jtmaston/CIMPLC-Hardware/docs/docfiles/topics/CAN.md

# CAN

WIP Section

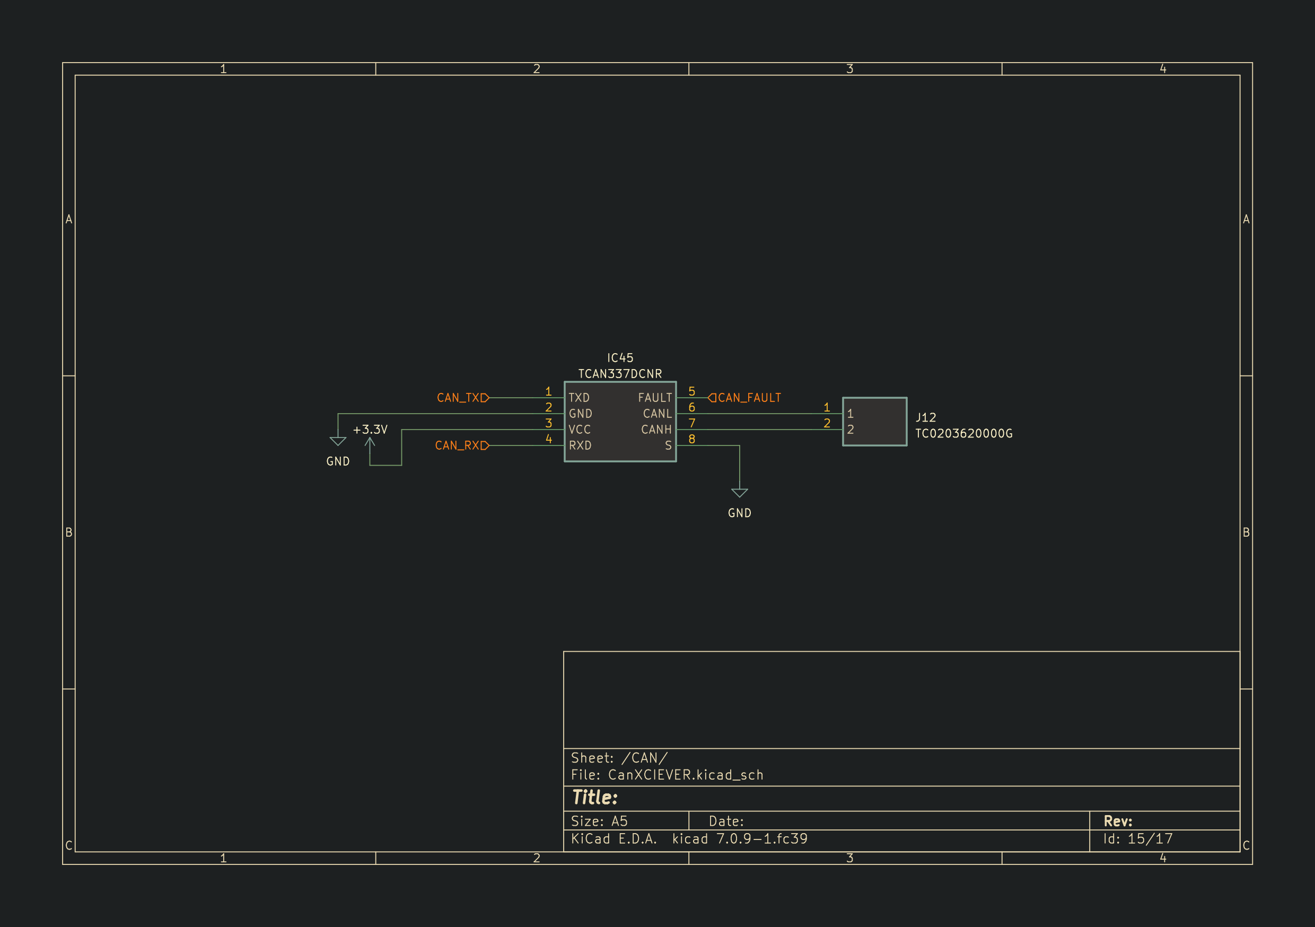
[picture p2: docs/CIMPLC-Hardware/image_4.png]
