jtmaston/CIMPLC-Hardware/docs/docfiles/topics/EEPROM.md

# EEPROM

WIP Section

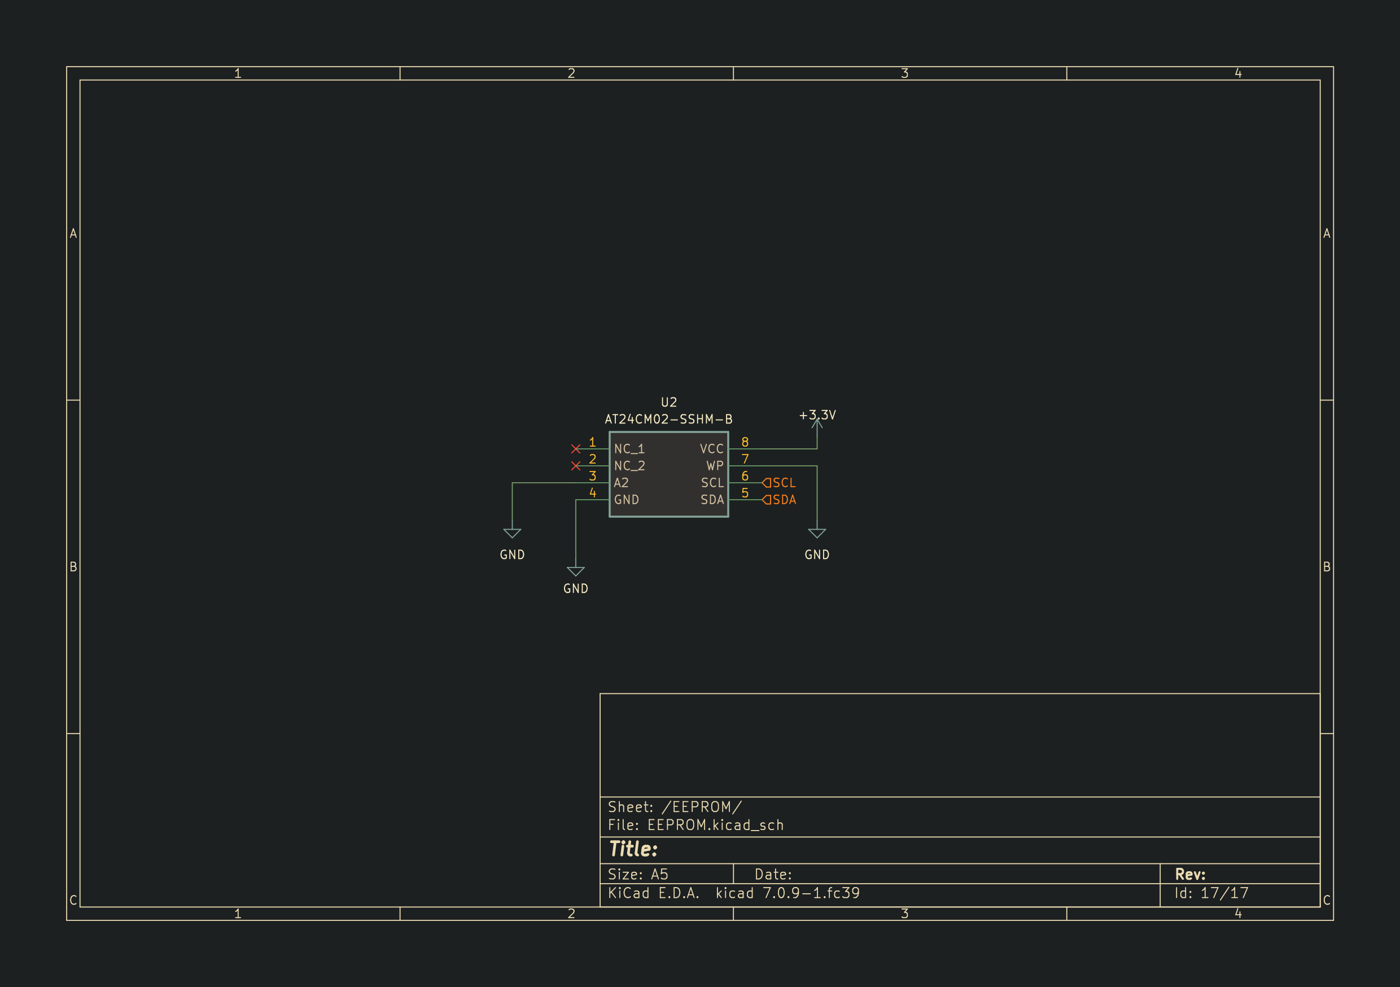
[picture p4: docs/CIMPLC-Hardware/image_6.png]
