jtmaston/CIMPLC-Hardware/docs/docfiles/topics/I-Block.md

# I Block

WIP Section

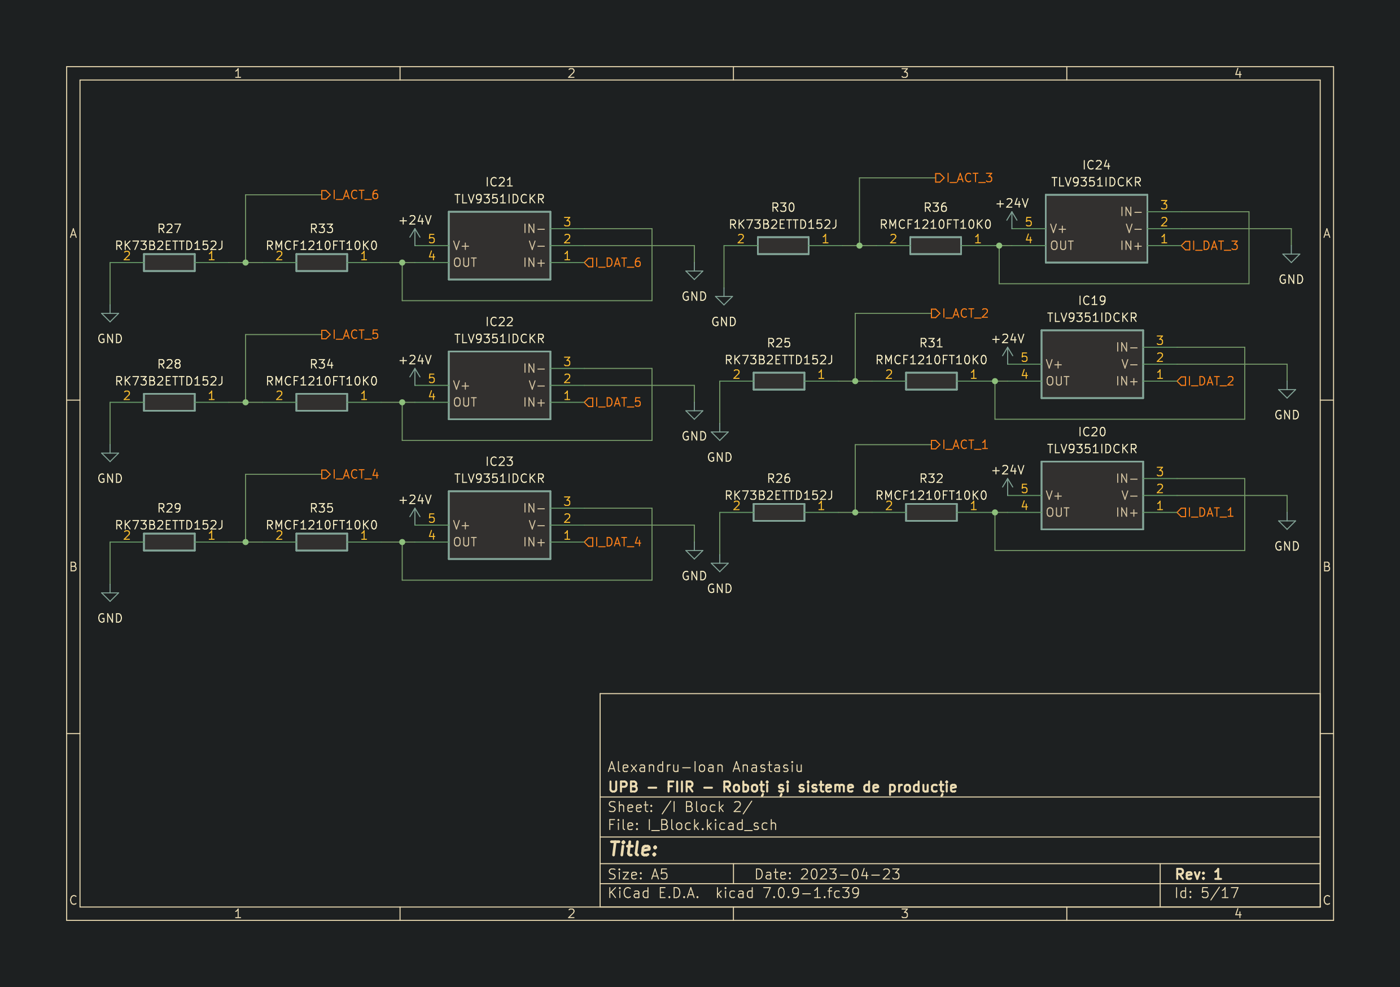
[picture p5: docs/CIMPLC-Hardware/image_7.png]
