jtmaston/CIMPLC-Hardware/docs/docfiles/topics/Output-Block.md

# Output Block

WIP Section

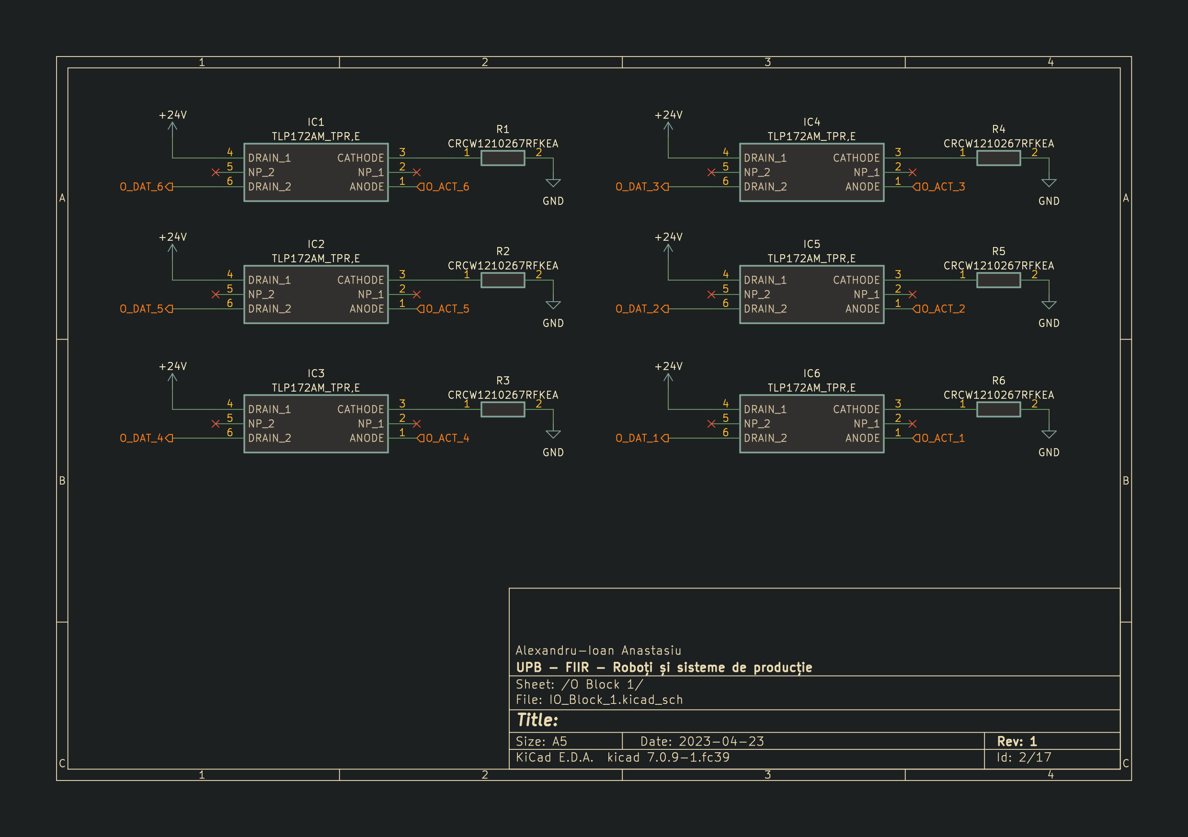
[picture p6: docs/CIMPLC-Hardware/image_1.png]
