jtmaston/CIMPLC-Hardware/docs/docfiles/topics/Remote-I-O.md

# Remote I/O

WIP Section

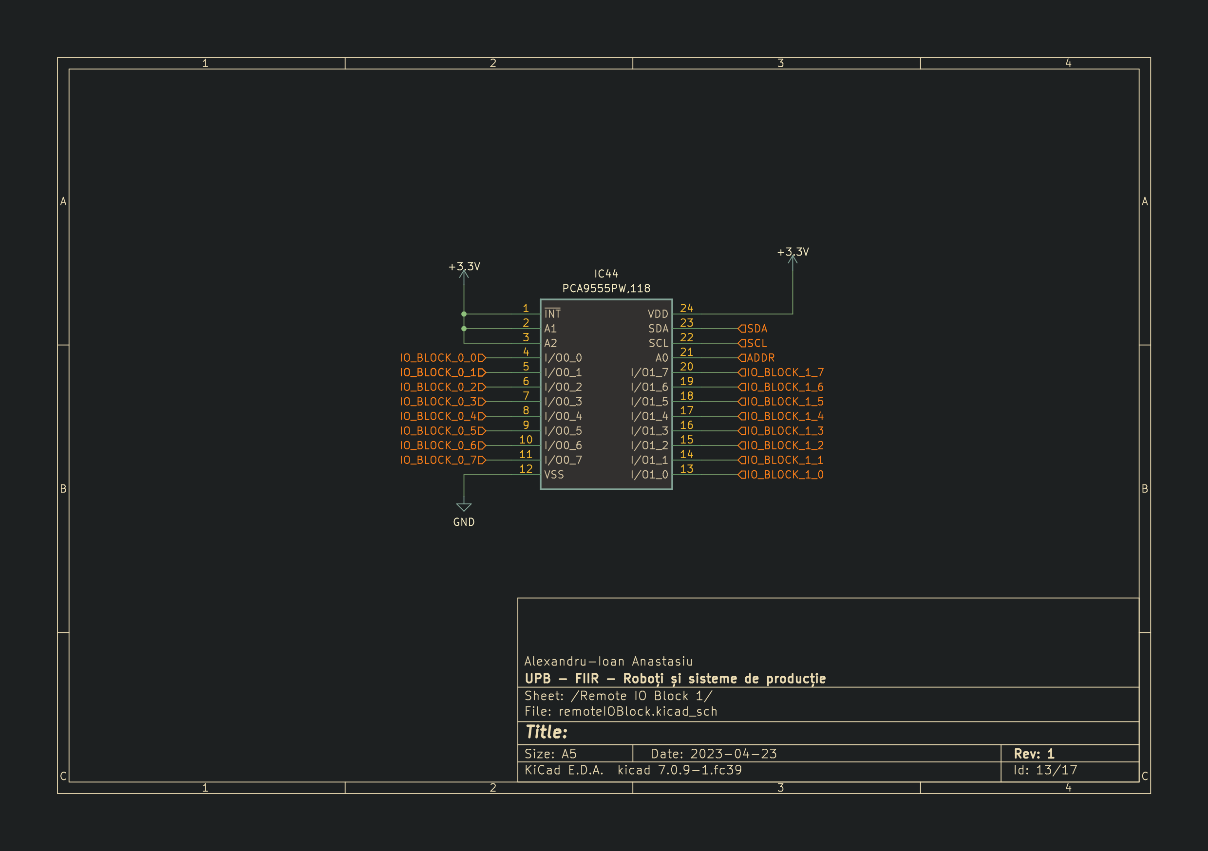
[picture p7: docs/CIMPLC-Hardware/image_2.png]
