jtmaston/CIMPLC-Hardware/docs/docfiles/topics/RS232.md

# RS232

WIP Section

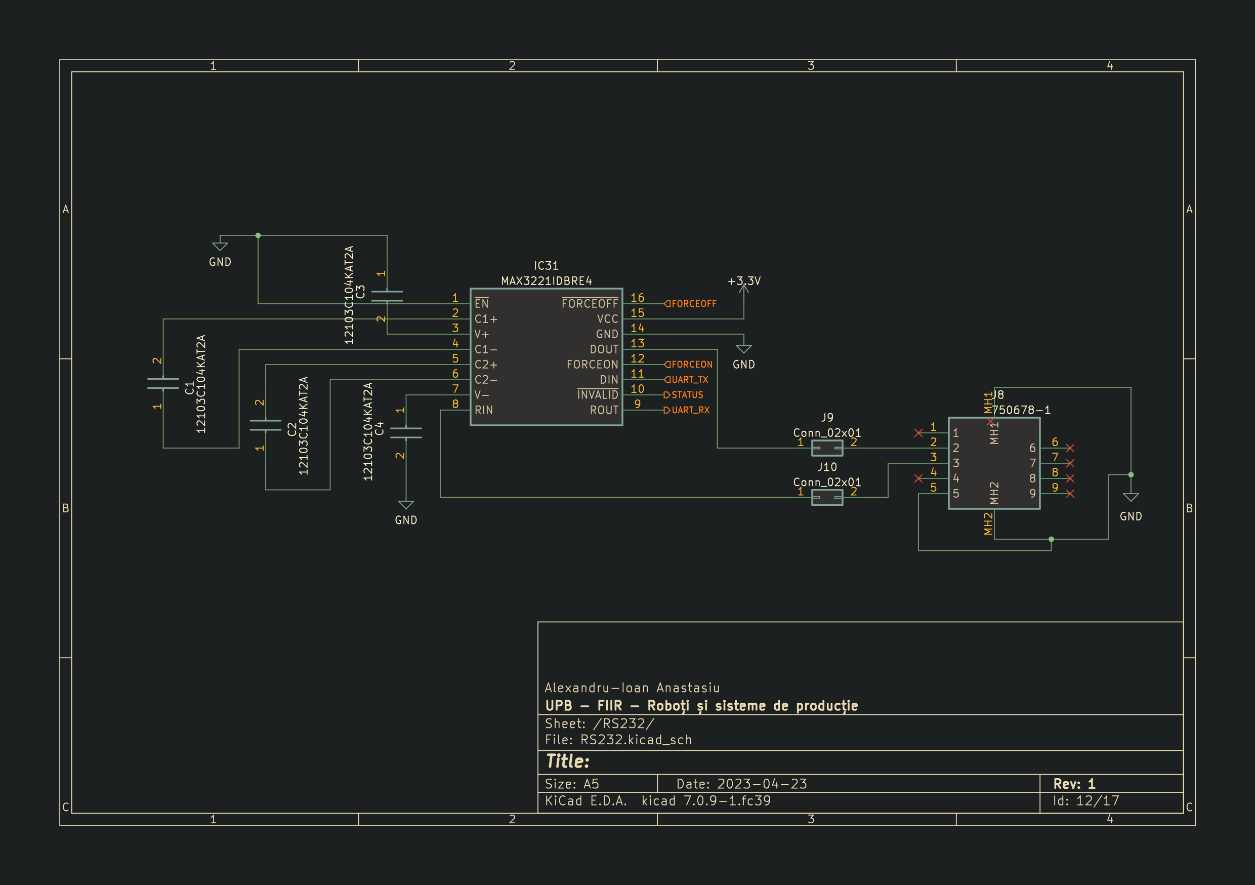
[picture p8: docs/CIMPLC-Hardware/image_3.png]
