jtmaston/CIMPLC-Hardware/docs/docfiles/topics/RS485.md

# RS485

WIP Section

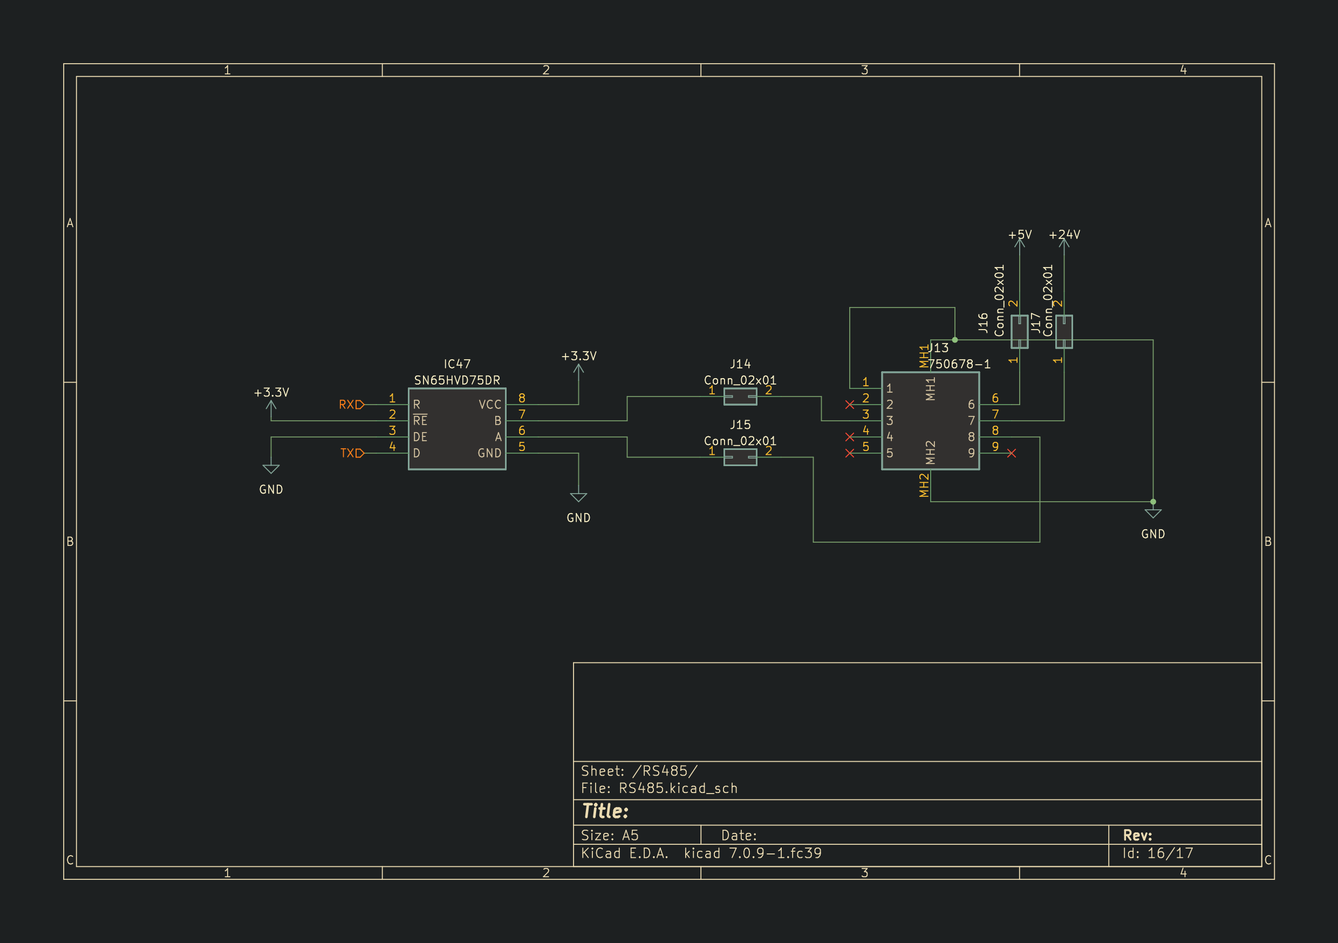
[picture p9: docs/CIMPLC-Hardware/image_5.png]
