jtmaston/CIMPLC-Hardware/docs/docfiles/images/image.png

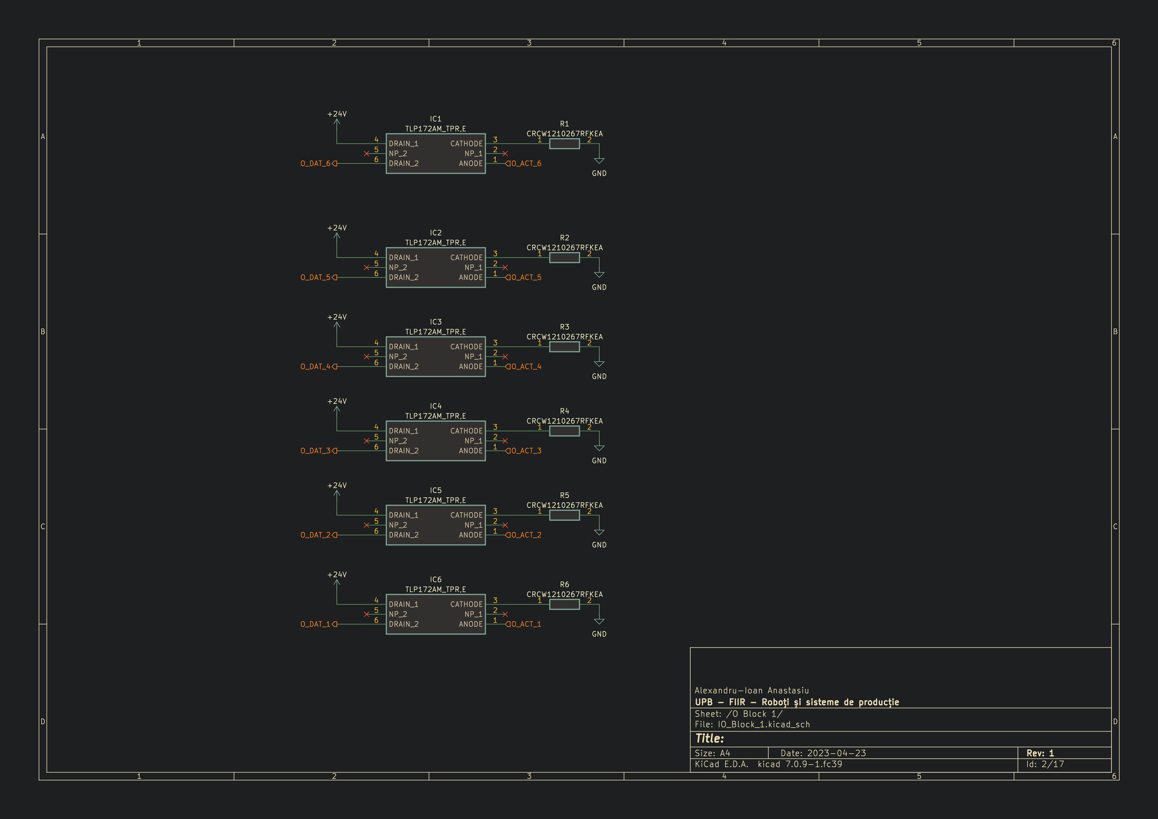
docs/docfiles/images/image.png
