jtmaston/CIMPLC-Hardware/v2/PLC-CIM.kicad_pcb

## KiCad design v2/PLC-CIM.kicad_pcb (2024-04-08)

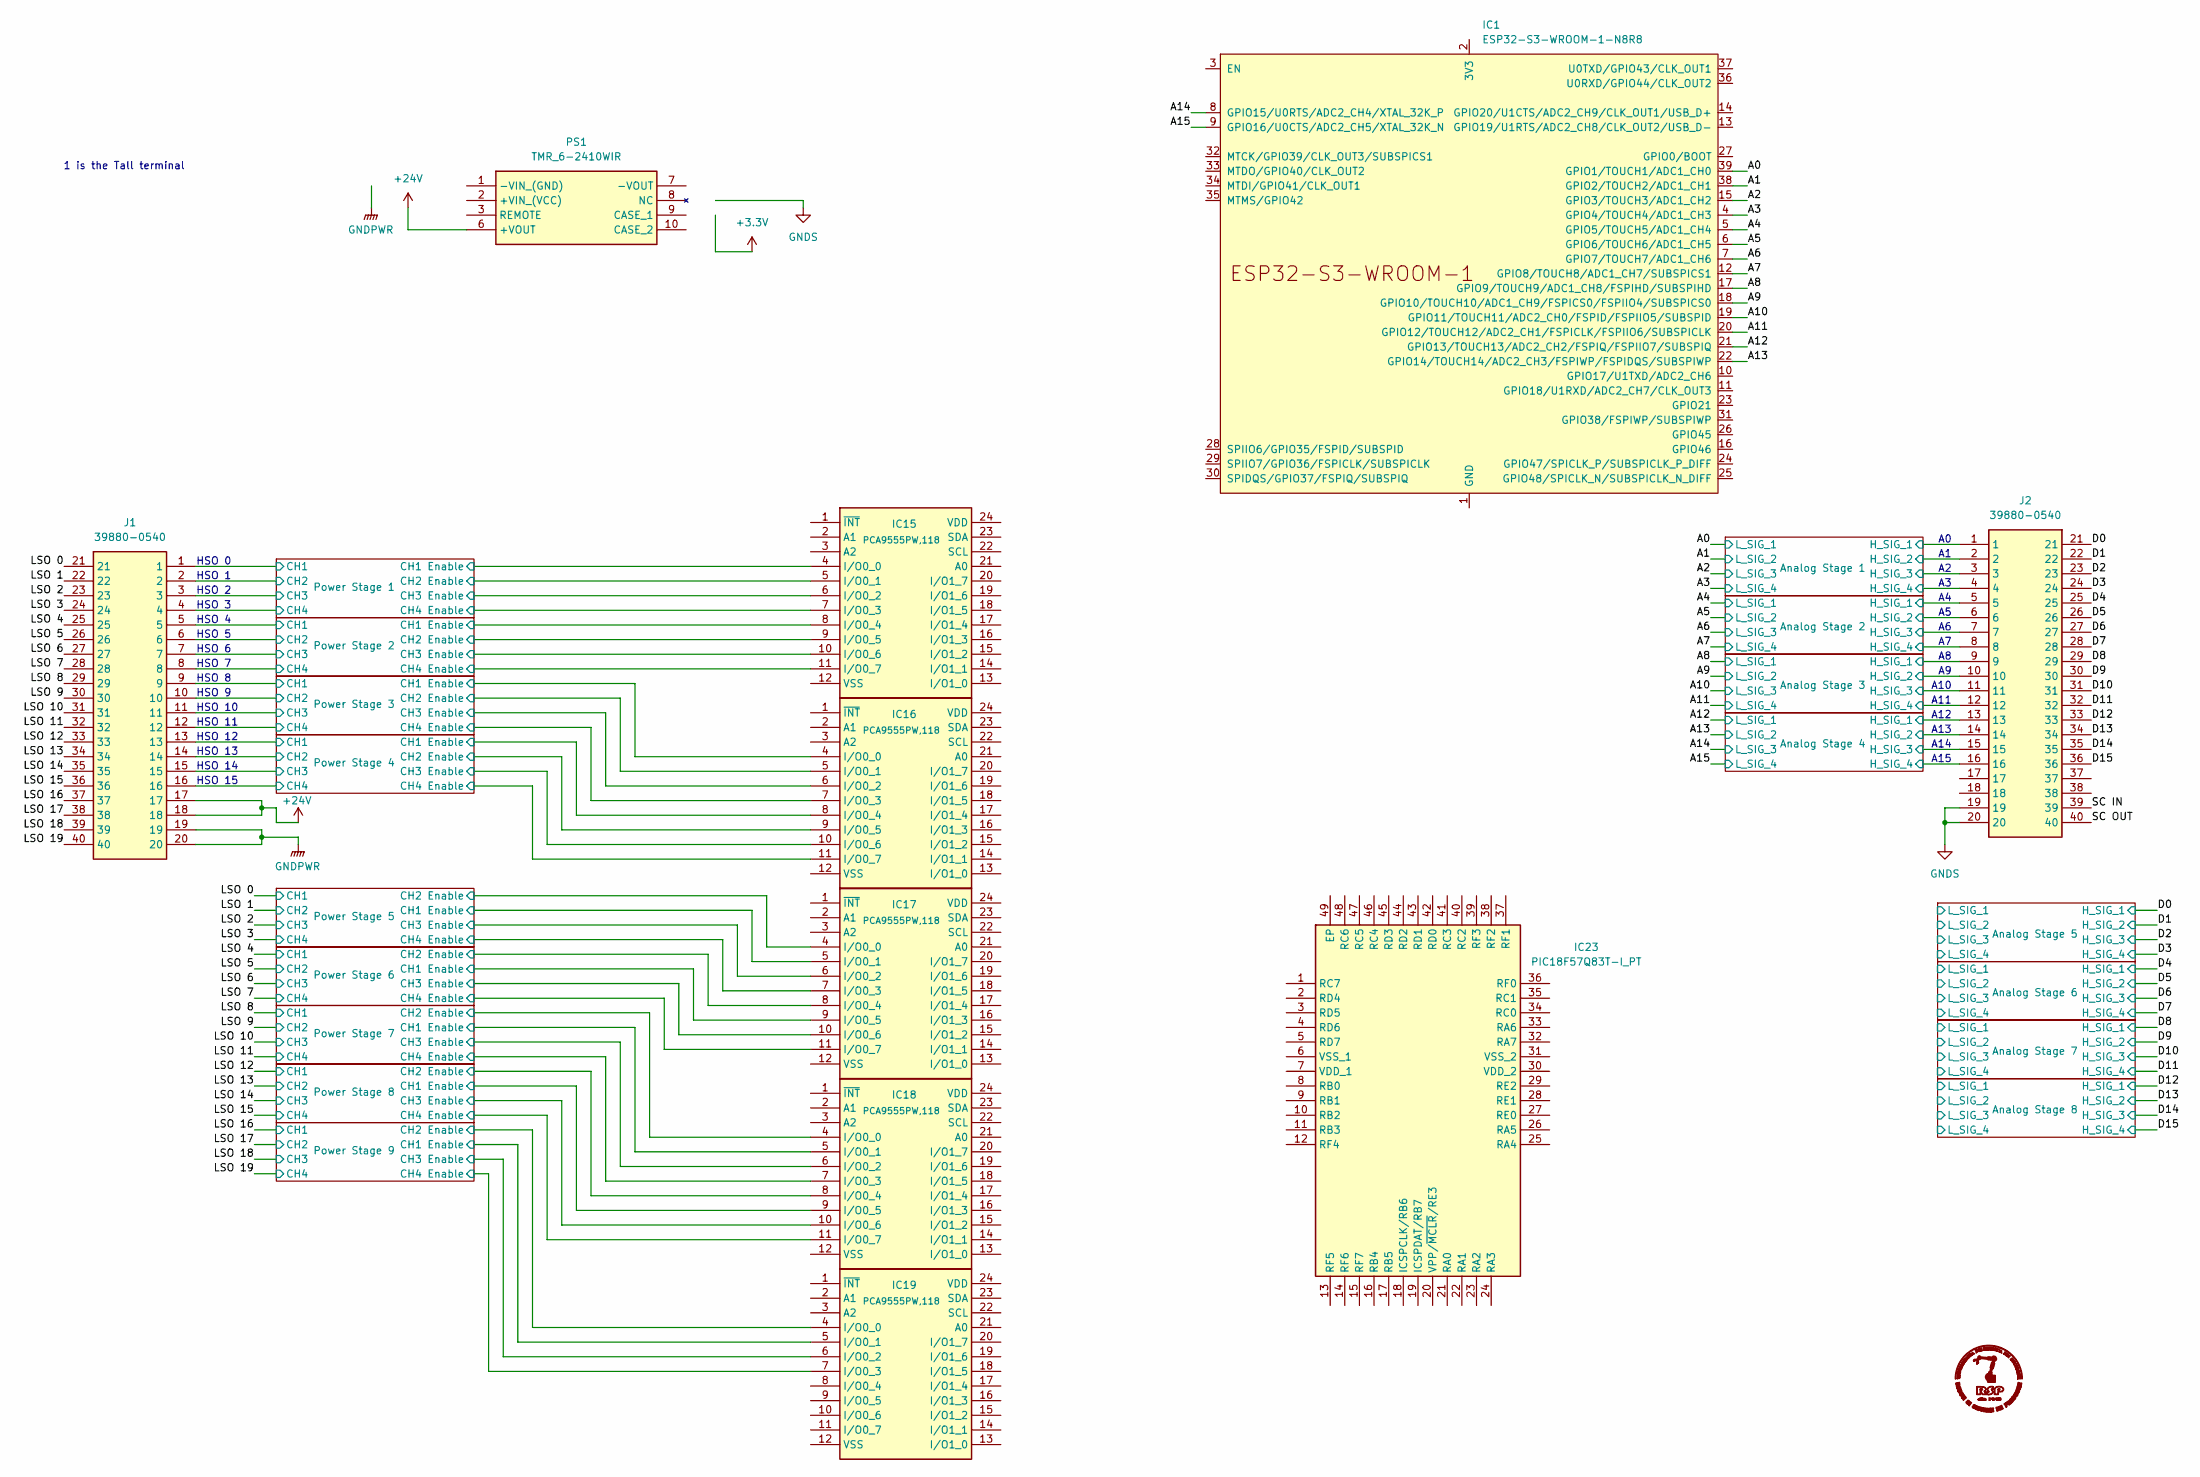
[picture p11: schematic PLC-CIM.kicad_sch, PLC CIM]

Parts:
IC1: ESP32-S3-WROOM-1-N8R8; ESP32S3WROOM1N8R8; Mouser Part Number 356-EP32S3WROOM1N8R8
IC15, IC16, IC17, IC18, IC19: PCA9555PW,118; SOP65P640X110-24N; Mouser Part Number 771-PCA9555PW-T
IC23: PIC18F57Q83T-I_PT; QFP50P900X900X120-49N; Mouser Part Number N/A
J1, J2: 39880-0540; 398800540; Mouser Part Number 538-39880-0540
PS1: TMR_6-2410WIR; TMR62410WIR; Mouser Part Number 495-TMR6-2410WIR

Connections:
+24V: J1.17, J1.18, PS1.6 (+VOUT); also elsewhere on the board
/A0: IC1.39 (GPIO1/TOUCH1/ADC1_CH0); also elsewhere on the board
/A1: IC1.38 (GPIO2/TOUCH2/ADC1_CH1); also elsewhere on the board
/A2: IC1.15 (GPIO3/TOUCH3/ADC1_CH2); also elsewhere on the board
/A3: IC1.4 (GPIO4/TOUCH4/ADC1_CH3); also elsewhere on the board
/A4: IC1.5 (GPIO5/TOUCH5/ADC1_CH4); also elsewhere on the board
/A5: IC1.6 (GPIO6/TOUCH6/ADC1_CH5); also elsewhere on the board
/A6: IC1.7 (GPIO7/TOUCH7/ADC1_CH6); also elsewhere on the board
/A7: IC1.12 (GPIO8/TOUCH8/ADC1_CH7/SUBSPICS1); also elsewhere on the board
/A8: IC1.17 (GPIO9/TOUCH9/ADC1_CH8/FSPIHD/SUBSPIHD); also elsewhere on the board
/A9: IC1.18 (GPIO10/TOUCH10/ADC1_CH9/FSPICS0/FSPIIO4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); also elsewhere on the board
/A10: IC1.19 (GPIO11/TOUCH11/ADC2_CH0/FSPID/FSPIIO5/S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); also elsewhere on the board
/A11: IC1.20 (GPIO12/TOUCH12/ADC2_CH1/FSPICLK/FSPIIO6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); also elsewhere on the board
/A12: IC1.21 (GPIO13/TOUCH13/ADC2_CH2/FSPIQ/FSPIIO7/S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); also elsewhere on the board
/A13: IC1.22 (GPIO14/TOUCH14/ADC2_CH3/FSPIWP/FSPIDQS/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); also elsewhere on the board
/A14: IC1.8 (GPIO15/U0RTS/ADC2_CH4/XTAL_32K_P); also elsewhere on the board
/A15: IC1.9 (GPIO16/U0CTS/ADC2_CH5/XTAL_32K_N); also elsewhere on the board
/Analog Stage 1/H_SIG_1: J2.1; also elsewhere on the board
/Analog Stage 1/H_SIG_2: J2.2; also elsewhere on the board
/Analog Stage 1/H_SIG_3: J2.3; also elsewhere on the board
/Analog Stage 1/H_SIG_4: J2.4; also elsewhere on the board
/Analog Stage 2/H_SIG_1: J2.5; also elsewhere on the board
/Analog Stage 2/H_SIG_2: J2.6; also elsewhere on the board
/Analog Stage 2/H_SIG_3: J2.7; also elsewhere on the board
/Analog Stage 2/H_SIG_4: J2.8; also elsewhere on the board
/Analog Stage 3/H_SIG_1: J2.9; also elsewhere on the board
/Analog Stage 3/H_SIG_2: J2.10; also elsewhere on the board
/Analog Stage 3/H_SIG_3: J2.11; also elsewhere on the board
/Analog Stage 3/H_SIG_4: J2.12; also elsewhere on the board
/Analog Stage 4/H_SIG_1: J2.13; also elsewhere on the board
/Analog Stage 4/H_SIG_2: J2.14; also elsewhere on the board
/Analog Stage 4/H_SIG_3: J2.15; also elsewhere on the board
/Analog Stage 4/H_SIG_4: J2.16; also elsewhere on the board
/D0: J2.21; also elsewhere on the board
/D1: J2.22; also elsewhere on the board
/D2: J2.23; also elsewhere on the board
/D3: J2.24; also elsewhere on the board
/D4: J2.25; also elsewhere on the board
/D5: J2.26; also elsewhere on the board
/D6: J2.27; also elsewhere on the board
/D7: J2.28; also elsewhere on the board
/D8: J2.29; also elsewhere on the board
/D9: J2.30; also elsewhere on the board
/D10: J2.31; also elsewhere on the board
/D11: J2.32; also elsewhere on the board
/D12: J2.33; also elsewhere on the board
/D13: J2.34; also elsewhere on the board
/D14: J2.35; also elsewhere on the board
/D15: J2.36; also elsewhere on the board
/LSO 0: J1.21; also elsewhere on the board
/LSO 1: J1.22; also elsewhere on the board
/LSO 2: J1.23; also elsewhere on the board
/LSO 3: J1.24; also elsewhere on the board
/LSO 4: J1.25; also elsewhere on the board
/LSO 5: J1.26; also elsewhere on the board
/LSO 6: J1.27; also elsewhere on the board
/LSO 7: J1.28; also elsewhere on the board
/LSO 8: J1.29; also elsewhere on the board
/LSO 9: J1.30; also elsewhere on the board
/LSO 10: J1.31; also elsewhere on the board
/LSO 11: J1.32; also elsewhere on the board
/LSO 12: J1.33; also elsewhere on the board
/LSO 13: J1.34; also elsewhere on the board
/LSO 14: J1.35; also elsewhere on the board
/LSO 15: J1.36; also elsewhere on the board
/LSO 16: J1.37; also elsewhere on the board
/LSO 17: J1.38; also elsewhere on the board
/LSO 18: J1.39; also elsewhere on the board
/LSO 19: J1.40; also elsewhere on the board
/Power Stage 1/CH1: J1.1; also elsewhere on the board
/Power Stage 1/CH1 Enable: IC15.4 (I/O0_0); also elsewhere on the board
/Power Stage 1/CH2: J1.2; also elsewhere on the board
/Power Stage 1/CH2 Enable: IC15.5 (I/O0_1); also elsewhere on the board
/Power Stage 1/CH3: J1.3; also elsewhere on the board
/Power Stage 1/CH3 Enable: IC15.6 (I/O0_2); also elsewhere on the board
/Power Stage 1/CH4: J1.4; also elsewhere on the board
/Power Stage 1/CH4 Enable: IC15.7 (I/O0_3); also elsewhere on the board
/Power Stage 2/CH1: J1.5; also elsewhere on the board
/Power Stage 2/CH1 Enable: IC15.8 (I/O0_4); also elsewhere on the board
/Power Stage 2/CH2: J1.6; also elsewhere on the board
/Power Stage 2/CH2 Enable: IC15.9 (I/O0_5); also elsewhere on the board
/Power Stage 2/CH3: J1.7; also elsewhere on the board
/Power Stage 2/CH3 Enable: IC15.10 (I/O0_6); also elsewhere on the board
/Power Stage 2/CH4: J1.8; also elsewhere on the board
/Power Stage 2/CH4 Enable: IC15.11 (I/O0_7); also elsewhere on the board
/Power Stage 3/CH1: J1.9; also elsewhere on the board
/Power Stage 3/CH1 Enable: IC16.4 (I/O0_0); also elsewhere on the board
/Power Stage 3/CH2: J1.10; also elsewhere on the board
/Power Stage 3/CH2 Enable: IC16.5 (I/O0_1); also elsewhere on the board
/Power Stage 3/CH3: J1.11; also elsewhere on the board
/Power Stage 3/CH3 Enable: IC16.6 (I/O0_2); also elsewhere on the board
/Power Stage 3/CH4: J1.12; also elsewhere on the board
/Power Stage 3/CH4 Enable: IC16.7 (I/O0_3); also elsewhere on the board
/Power Stage 4/CH1: J1.13; also elsewhere on the board
/Power Stage 4/CH1 Enable: IC16.8 (I/O0_4); also elsewhere on the board
/Power Stage 4/CH2: J1.14; also elsewhere on the board
/Power Stage 4/CH2 Enable: IC16.9 (I/O0_5); also elsewhere on the board
/Power Stage 4/CH3: J1.15; also elsewhere on the board
/Power Stage 4/CH3 Enable: IC16.10 (I/O0_6); also elsewhere on the board
/Power Stage 4/CH4: J1.16; also elsewhere on the board
/Power Stage 4/CH4 Enable: IC16.11 (I/O0_7); also elsewhere on the board
/Power Stage 5/CH1 Enable: IC17.5 (I/O0_1); also elsewhere on the board
/Power Stage 5/CH2 Enable: IC17.4 (I/O0_0); also elsewhere on the board
/Power Stage 5/CH3 Enable: IC17.6 (I/O0_2); also elsewhere on the board
/Power Stage 5/CH4 Enable: IC17.7 (I/O0_3); also elsewhere on the board
/Power Stage 6/CH1 Enable: IC17.9 (I/O0_5); also elsewhere on the board
/Power Stage 6/CH2 Enable: IC17.8 (I/O0_4); also elsewhere on the board
/Power Stage 6/CH3 Enable: IC17.10 (I/O0_6); also elsewhere on the board
/Power Stage 6/CH4 Enable: IC17.11 (I/O0_7); also elsewhere on the board
/Power Stage 7/CH1 Enable: IC18.5 (I/O0_1); also elsewhere on the board
/Power Stage 7/CH2 Enable: IC18.4 (I/O0_0); also elsewhere on the board
/Power Stage 7/CH3 Enable: IC18.6 (I/O0_2); also elsewhere on the board
/Power Stage 7/CH4 Enable: IC18.7 (I/O0_3); also elsewhere on the board
/Power Stage 8/CH1 Enable: IC18.9 (I/O0_5); also elsewhere on the board
/Power Stage 8/CH2 Enable: IC18.8 (I/O0_4); also elsewhere on the board
/Power Stage 8/CH3 Enable: IC18.10 (I/O0_6); also elsewhere on the board
/Power Stage 8/CH4 Enable: IC18.11 (I/O0_7); also elsewhere on the board
/Power Stage 9/CH1 Enable: IC19.5 (I/O0_1); also elsewhere on the board
/Power Stage 9/CH2 Enable: IC19.4 (I/O0_0); also elsewhere on the board
/Power Stage 9/CH3 Enable: IC19.6 (I/O0_2); also elsewhere on the board
/Power Stage 9/CH4 Enable: IC19.7 (I/O0_3); also elsewhere on the board
/SC IN: J2.39
/SC OUT: J2.40
GNDPWR: J1.19, J1.20; also elsewhere on the board
GNDS: J2.19, J2.20; also elsewhere on the board
unnamed: IC1.1 (GND), IC1.40 (GND), IC1.41 (GND)

Notes on the sheet:
HSO 4
HSO 11
HSO 0
A12
HSO 10
HSO 15
HSO 12
A14
1 is the Tall terminal
HSO 13
HSO 5
HSO 14
HSO 3
A13
HSO 9
HSO 2
HSO 1
HSO 8
HSO 6
A10
HSO 7
A11
A15

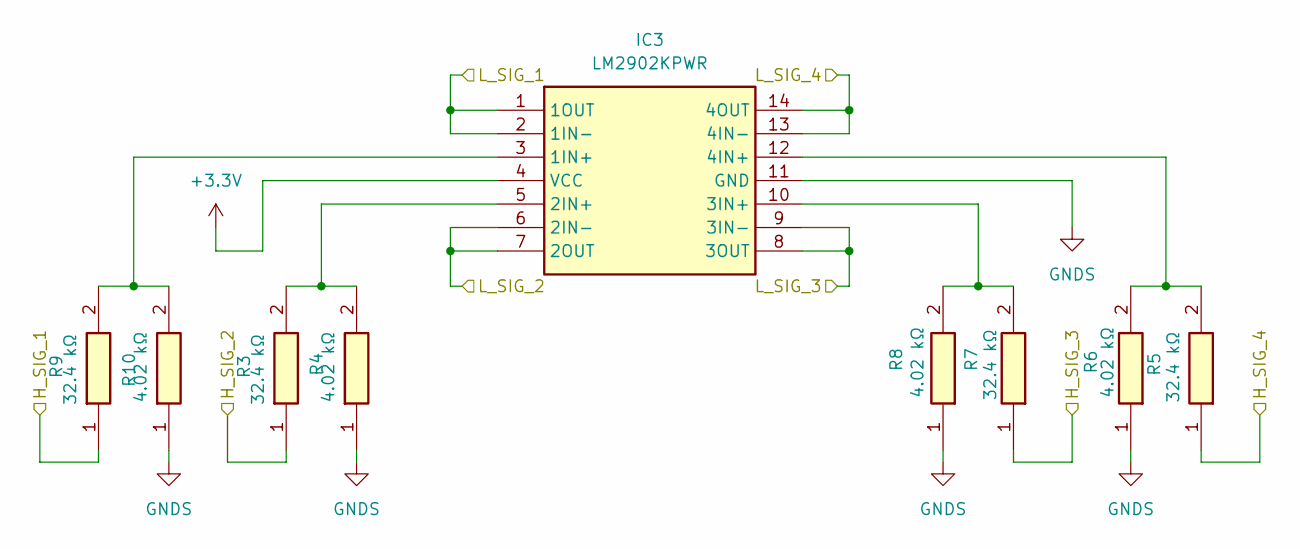
[picture p12: schematic ASS.kicad_sch]

Parts:
IC3: LM2902KPWR; SOP65P640X120-14N; Mouser Part Number 595-LM2902KPWR
R3, R5, R7, R9: 32.4 kΩ; RESC1609X55N; Mouser Part Number 667-ERJ-P03F3242V
R4, R6, R8, R10: 4.02 kΩ; RESC1609X55N; Mouser Part Number 71-CRCW12064K02FKEAH

Connections:
+3.3V: IC3.4 (VCC); also elsewhere on the board
/A4: IC3.1 (1OUT), IC3.2 (1IN-); also elsewhere on the board
/A5: IC3.6 (2IN-), IC3.7 (2OUT); also elsewhere on the board
/A6: IC3.8 (3OUT), IC3.9 (3IN-); also elsewhere on the board
/A7: IC3.13 (4IN-), IC3.14 (4OUT); also elsewhere on the board
/Analog Stage 1/H_SIG_2: R3.1; also elsewhere on the board
/Analog Stage 1/H_SIG_3: R7.1; also elsewhere on the board
/Analog Stage 1/H_SIG_4: R5.1; also elsewhere on the board
/Analog Stage 2/H_SIG_1: R9.1; also elsewhere on the board
GNDS: IC3.11 (GND), R4.1, R6.1, R8.1, R10.1; also elsewhere on the board
unnamed: IC3.3 (1IN+), R9.2, R10.2

Parts of its further copies:
IC2, IC4, IC5, IC20, IC21, IC22, IC24: LM2902KPWR; SOP65P640X120-14N; Mouser Part Number 595-LM2902KPWR
R1, R11, R14, R16, R17, R19, R22, R24, R25, R27, R30, R32, R33, R35, R38, R40, R41, R44, R46, R47, R49, R52, R54, R55, R57, R60, R62, R63: 32.4 kΩ; RESC1609X55N; Mouser Part Number 667-ERJ-P03F3242V
R2, R12, R13, R15, R18, R20, R21, R23, R26, R28, R29, R31, R34, R36, R37, R39, R42, R43, R45, R48, R50, R51, R53, R56, R58, R59, R61, R64: 4.02 kΩ; RESC1609X55N; Mouser Part Number 71-CRCW12064K02FKEAH

Connections of its further copies:
+3.3V: IC2.4 (VCC), IC4.4 (VCC), IC5.4 (VCC), IC20.4 (VCC), IC21.4 (VCC), IC22.4 (VCC), IC24.4 (VCC); also elsewhere on the board
/A0: IC24.1 (1OUT), IC24.2 (1IN-); also elsewhere on the board
/A1: IC24.6 (2IN-), IC24.7 (2OUT); also elsewhere on the board
/A2: IC24.8 (3OUT), IC24.9 (3IN-); also elsewhere on the board
/A3: IC24.13 (4IN-), IC24.14 (4OUT); also elsewhere on the board
/A8: IC4.1 (1OUT), IC4.2 (1IN-); also elsewhere on the board
/A9: IC4.6 (2IN-), IC4.7 (2OUT); also elsewhere on the board
/A10: IC4.8 (3OUT), IC4.9 (3IN-); also elsewhere on the board
/A11: IC4.13 (4IN-), IC4.14 (4OUT); also elsewhere on the board
/A12: IC5.1 (1OUT), IC5.2 (1IN-); also elsewhere on the board
/A13: IC5.6 (2IN-), IC5.7 (2OUT); also elsewhere on the board
/A14: IC5.8 (3OUT), IC5.9 (3IN-); also elsewhere on the board
/A15: IC5.13 (4IN-), IC5.14 (4OUT); also elsewhere on the board
/Analog Stage 1/H_SIG_1: R25.1; also elsewhere on the board
/Analog Stage 2/H_SIG_2: R11.1; also elsewhere on the board
/Analog Stage 2/H_SIG_3: R14.1; also elsewhere on the board
/Analog Stage 2/H_SIG_4: R16.1; also elsewhere on the board
/Analog Stage 3/H_SIG_1: R17.1; also elsewhere on the board
/Analog Stage 3/H_SIG_2: R19.1; also elsewhere on the board
/Analog Stage 3/H_SIG_3: R22.1; also elsewhere on the board
/Analog Stage 3/H_SIG_4: R24.1; also elsewhere on the board
/Analog Stage 4/H_SIG_1: R63.1; also elsewhere on the board
/Analog Stage 4/H_SIG_2: R27.1; also elsewhere on the board
/Analog Stage 4/H_SIG_3: R30.1; also elsewhere on the board
/Analog Stage 4/H_SIG_4: R32.1; also elsewhere on the board
/Analog Stage 5/L_SIG_1: IC20.1 (1OUT), IC20.2 (1IN-)
/Analog Stage 5/L_SIG_2: IC20.6 (2IN-), IC20.7 (2OUT)
/Analog Stage 5/L_SIG_3: IC20.8 (3OUT), IC20.9 (3IN-)
/Analog Stage 5/L_SIG_4: IC20.13 (4IN-), IC20.14 (4OUT)
/Analog Stage 6/L_SIG_1: IC2.1 (1OUT), IC2.2 (1IN-)
/Analog Stage 6/L_SIG_2: IC2.6 (2IN-), IC2.7 (2OUT)
/Analog Stage 6/L_SIG_3: IC2.8 (3OUT), IC2.9 (3IN-)
/Analog Stage 6/L_SIG_4: IC2.13 (4IN-), IC2.14 (4OUT)
/Analog Stage 7/L_SIG_1: IC21.1 (1OUT), IC21.2 (1IN-)
/Analog Stage 7/L_SIG_2: IC21.6 (2IN-), IC21.7 (2OUT)
/Analog Stage 7/L_SIG_3: IC21.8 (3OUT), IC21.9 (3IN-)
/Analog Stage 7/L_SIG_4: IC21.13 (4IN-), IC21.14 (4OUT)
/Analog Stage 8/L_SIG_1: IC22.1 (1OUT), IC22.2 (1IN-)
/Analog Stage 8/L_SIG_2: IC22.6 (2IN-), IC22.7 (2OUT)
/Analog Stage 8/L_SIG_3: IC22.8 (3OUT), IC22.9 (3IN-)
/Analog Stage 8/L_SIG_4: IC22.13 (4IN-), IC22.14 (4OUT)
/D0: R33.1; also elsewhere on the board
/D1: R35.1; also elsewhere on the board
/D2: R38.1; also elsewhere on the board
/D3: R40.1; also elsewhere on the board
/D4: R1.1; also elsewhere on the board
/D5: R41.1; also elsewhere on the board
/D6: R44.1; also elsewhere on the board
/D7: R46.1; also elsewhere on the board
/D8: R47.1; also elsewhere on the board
/D9: R49.1; also elsewhere on the board
/D10: R52.1; also elsewhere on the board
/D11: R54.1; also elsewhere on the board
/D12: R55.1; also elsewhere on the board
/D13: R57.1; also elsewhere on the board
/D14: R60.1; also elsewhere on the board
/D15: R62.1; also elsewhere on the board
GNDS: IC2.11 (GND), IC4.11 (GND), IC5.11 (GND), IC20.11 (GND), IC21.11 (GND), IC22.11 (GND), IC24.11 (GND), R2.1, R12.1, R13.1, R15.1, R18.1, R20.1, R21.1, R23.1, R26.1, R28.1, R29.1, R31.1, R34.1, R36.1, R37.1, R39.1, R42.1, R43.1, R45.1, R48.1, R50.1, R51.1, R53.1, R56.1, R58.1, R59.1, R61.1, R64.1; also elsewhere on the board
unnamed: IC2.3 (1IN+), R1.2, R2.2
unnamed: IC2.5 (2IN+), R41.2, R42.2
unnamed: IC2.10 (3IN+), R43.2, R44.2
unnamed: IC2.12 (4IN+), R45.2, R46.2
unnamed: IC4.3 (1IN+), R17.2, R18.2
unnamed: IC4.5 (2IN+), R19.2, R20.2
unnamed: IC4.10 (3IN+), R21.2, R22.2
unnamed: IC4.12 (4IN+), R23.2, R24.2
unnamed: IC5.3 (1IN+), R63.2, R64.2
unnamed: IC5.5 (2IN+), R27.2, R28.2
unnamed: IC5.10 (3IN+), R29.2, R30.2
unnamed: IC5.12 (4IN+), R31.2, R32.2
unnamed: IC20.3 (1IN+), R33.2, R34.2
unnamed: IC20.5 (2IN+), R35.2, R36.2
unnamed: IC20.10 (3IN+), R37.2, R38.2
unnamed: IC20.12 (4IN+), R39.2, R40.2
unnamed: IC21.3 (1IN+), R47.2, R48.2
unnamed: IC21.5 (2IN+), R49.2, R50.2
unnamed: IC21.10 (3IN+), R51.2, R52.2
unnamed: IC21.12 (4IN+), R53.2, R54.2
unnamed: IC22.3 (1IN+), R55.2, R56.2
unnamed: IC22.5 (2IN+), R57.2, R58.2
unnamed: IC22.10 (3IN+), R59.2, R60.2
unnamed: IC22.12 (4IN+), R61.2, R62.2
unnamed: IC24.3 (1IN+), R25.2, R26.2

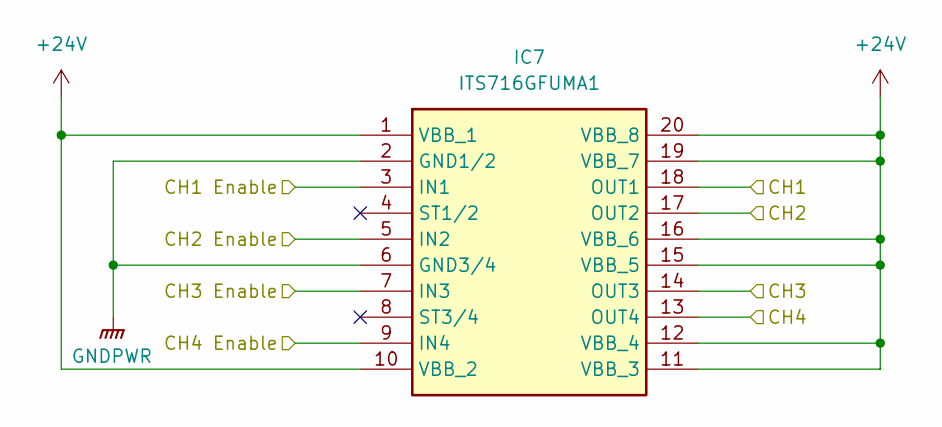
[picture p13: schematic PS.kicad_sch]

Parts:
IC7: ITS716GFUMA1; SOIC127P1030X265-20N; Mouser Part Number 726-ITS716GFUMA1

Connections:
+24V: IC7.1 (VBB_1), IC7.10 (VBB_2), IC7.11 (VBB_3), IC7.12 (VBB_4), IC7.15 (VBB_5), IC7.16 (VBB_6), IC7.19 (VBB_7), IC7.20 (VBB_8); also elsewhere on the board
/Power Stage 2/CH1: IC7.18 (OUT1); also elsewhere on the board
/Power Stage 2/CH1 Enable: IC7.3 (IN1); also elsewhere on the board
/Power Stage 2/CH2: IC7.17 (OUT2); also elsewhere on the board
/Power Stage 2/CH2 Enable: IC7.5 (IN2); also elsewhere on the board
/Power Stage 2/CH3: IC7.14 (OUT3); also elsewhere on the board
/Power Stage 2/CH3 Enable: IC7.7 (IN3); also elsewhere on the board
/Power Stage 2/CH4: IC7.13 (OUT4); also elsewhere on the board
/Power Stage 2/CH4 Enable: IC7.9 (IN4); also elsewhere on the board
GNDPWR: IC7.2 (GND1/2), IC7.6 (GND3/4); also elsewhere on the board

Parts of its further copies:
IC6, IC8, IC9, IC10, IC11, IC12, IC13, IC14: ITS716GFUMA1; SOIC127P1030X265-20N; Mouser Part Number 726-ITS716GFUMA1

Connections of its further copies:
+24V: IC6.1 (VBB_1), IC6.10 (VBB_2), IC6.11 (VBB_3), IC6.12 (VBB_4), IC6.15 (VBB_5), IC6.16 (VBB_6), IC6.19 (VBB_7), IC6.20 (VBB_8), IC8.1 (VBB_1), IC8.10 (VBB_2), IC8.11 (VBB_3), IC8.12 (VBB_4), IC8.15 (VBB_5), IC8.16 (VBB_6), IC8.19 (VBB_7), IC8.20 (VBB_8), IC9.1 (VBB_1), IC9.10 (VBB_2), IC9.11 (VBB_3), IC9.12 (VBB_4), IC9.15 (VBB_5), IC9.16 (VBB_6), IC9.19 (VBB_7), IC9.20 (VBB_8), IC10.1 (VBB_1), IC10.10 (VBB_2), IC10.11 (VBB_3), IC10.12 (VBB_4), IC10.15 (VBB_5), IC10.16 (VBB_6), IC10.19 (VBB_7), IC10.20 (VBB_8), IC11.1 (VBB_1), IC11.10 (VBB_2), IC11.11 (VBB_3), IC11.12 (VBB_4), IC11.15 (VBB_5), IC11.16 (VBB_6), IC11.19 (VBB_7), IC11.20 (VBB_8), IC12.1 (VBB_1), IC12.10 (VBB_2), IC12.11 (VBB_3), IC12.12 (VBB_4), IC12.15 (VBB_5), IC12.16 (VBB_6), IC12.19 (VBB_7), IC12.20 (VBB_8), IC13.1 (VBB_1), IC13.10 (VBB_2), IC13.11 (VBB_3), IC13.12 (VBB_4), IC13.15 (VBB_5), IC13.16 (VBB_6), IC13.19 (VBB_7), IC13.20 (VBB_8), IC14.1 (VBB_1), IC14.10 (VBB_2), IC14.11 (VBB_3), IC14.12 (VBB_4), IC14.15 (VBB_5), IC14.16 (VBB_6), IC14.19 (VBB_7), IC14.20 (VBB_8); also elsewhere on the board
/LSO 0: IC10.18 (OUT1); also elsewhere on the board
/LSO 1: IC10.17 (OUT2); also elsewhere on the board
/LSO 2: IC10.14 (OUT3); also elsewhere on the board
/LSO 3: IC10.13 (OUT4); also elsewhere on the board
/LSO 4: IC11.18 (OUT1); also elsewhere on the board
/LSO 5: IC11.17 (OUT2); also elsewhere on the board
/LSO 6: IC11.14 (OUT3); also elsewhere on the board
/LSO 7: IC11.13 (OUT4); also elsewhere on the board
/LSO 8: IC12.18 (OUT1); also elsewhere on the board
/LSO 9: IC12.17 (OUT2); also elsewhere on the board
/LSO 10: IC12.14 (OUT3); also elsewhere on the board
/LSO 11: IC12.13 (OUT4); also elsewhere on the board
/LSO 12: IC13.18 (OUT1); also elsewhere on the board
/LSO 13: IC13.17 (OUT2); also elsewhere on the board
/LSO 14: IC13.14 (OUT3); also elsewhere on the board
/LSO 15: IC13.13 (OUT4); also elsewhere on the board
/LSO 16: IC14.18 (OUT1); also elsewhere on the board
/LSO 17: IC14.17 (OUT2); also elsewhere on the board
/LSO 18: IC14.14 (OUT3); also elsewhere on the board
/LSO 19: IC14.13 (OUT4); also elsewhere on the board
/Power Stage 1/CH1: IC6.18 (OUT1); also elsewhere on the board
/Power Stage 1/CH1 Enable: IC6.3 (IN1); also elsewhere on the board
/Power Stage 1/CH2: IC6.17 (OUT2); also elsewhere on the board
/Power Stage 1/CH2 Enable: IC6.5 (IN2); also elsewhere on the board
/Power Stage 1/CH3: IC6.14 (OUT3); also elsewhere on the board
/Power Stage 1/CH3 Enable: IC6.7 (IN3); also elsewhere on the board
/Power Stage 1/CH4: IC6.13 (OUT4); also elsewhere on the board
/Power Stage 1/CH4 Enable: IC6.9 (IN4); also elsewhere on the board
/Power Stage 3/CH1: IC8.18 (OUT1); also elsewhere on the board
/Power Stage 3/CH1 Enable: IC8.3 (IN1); also elsewhere on the board
/Power Stage 3/CH2: IC8.17 (OUT2); also elsewhere on the board
/Power Stage 3/CH2 Enable: IC8.5 (IN2); also elsewhere on the board
/Power Stage 3/CH3: IC8.14 (OUT3); also elsewhere on the board
/Power Stage 3/CH3 Enable: IC8.7 (IN3); also elsewhere on the board
/Power Stage 3/CH4: IC8.13 (OUT4); also elsewhere on the board
/Power Stage 3/CH4 Enable: IC8.9 (IN4); also elsewhere on the board
/Power Stage 4/CH1: IC9.18 (OUT1); also elsewhere on the board
/Power Stage 4/CH1 Enable: IC9.3 (IN1); also elsewhere on the board
/Power Stage 4/CH2: IC9.17 (OUT2); also elsewhere on the board
/Power Stage 4/CH2 Enable: IC9.5 (IN2); also elsewhere on the board
/Power Stage 4/CH3: IC9.14 (OUT3); also elsewhere on the board
/Power Stage 4/CH3 Enable: IC9.7 (IN3); also elsewhere on the board
/Power Stage 4/CH4: IC9.13 (OUT4); also elsewhere on the board
/Power Stage 4/CH4 Enable: IC9.9 (IN4); also elsewhere on the board
/Power Stage 5/CH1 Enable: IC10.3 (IN1); also elsewhere on the board
/Power Stage 5/CH2 Enable: IC10.5 (IN2); also elsewhere on the board
/Power Stage 5/CH3 Enable: IC10.7 (IN3); also elsewhere on the board
/Power Stage 5/CH4 Enable: IC10.9 (IN4); also elsewhere on the board
/Power Stage 6/CH1 Enable: IC11.3 (IN1); also elsewhere on the board
/Power Stage 6/CH2 Enable: IC11.5 (IN2); also elsewhere on the board
/Power Stage 6/CH3 Enable: IC11.7 (IN3); also elsewhere on the board
/Power Stage 6/CH4 Enable: IC11.9 (IN4); also elsewhere on the board
/Power Stage 7/CH1 Enable: IC12.3 (IN1); also elsewhere on the board
/Power Stage 7/CH2 Enable: IC12.5 (IN2); also elsewhere on the board
/Power Stage 7/CH3 Enable: IC12.7 (IN3); also elsewhere on the board
/Power Stage 7/CH4 Enable: IC12.9 (IN4); also elsewhere on the board
/Power Stage 8/CH1 Enable: IC13.3 (IN1); also elsewhere on the board
/Power Stage 8/CH2 Enable: IC13.5 (IN2); also elsewhere on the board
/Power Stage 8/CH3 Enable: IC13.7 (IN3); also elsewhere on the board
/Power Stage 8/CH4 Enable: IC13.9 (IN4); also elsewhere on the board
/Power Stage 9/CH1 Enable: IC14.3 (IN1); also elsewhere on the board
/Power Stage 9/CH2 Enable: IC14.5 (IN2); also elsewhere on the board
/Power Stage 9/CH3 Enable: IC14.7 (IN3); also elsewhere on the board
/Power Stage 9/CH4 Enable: IC14.9 (IN4); also elsewhere on the board
GNDPWR: IC6.2 (GND1/2), IC6.6 (GND3/4), IC8.2 (GND1/2), IC8.6 (GND3/4), IC9.2 (GND1/2), IC9.6 (GND3/4), IC10.2 (GND1/2), IC10.6 (GND3/4), IC11.2 (GND1/2), IC11.6 (GND3/4), IC12.2 (GND1/2), IC12.6 (GND3/4), IC13.2 (GND1/2), IC13.6 (GND3/4), IC14.2 (GND1/2), IC14.6 (GND3/4); also elsewhere on the board

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
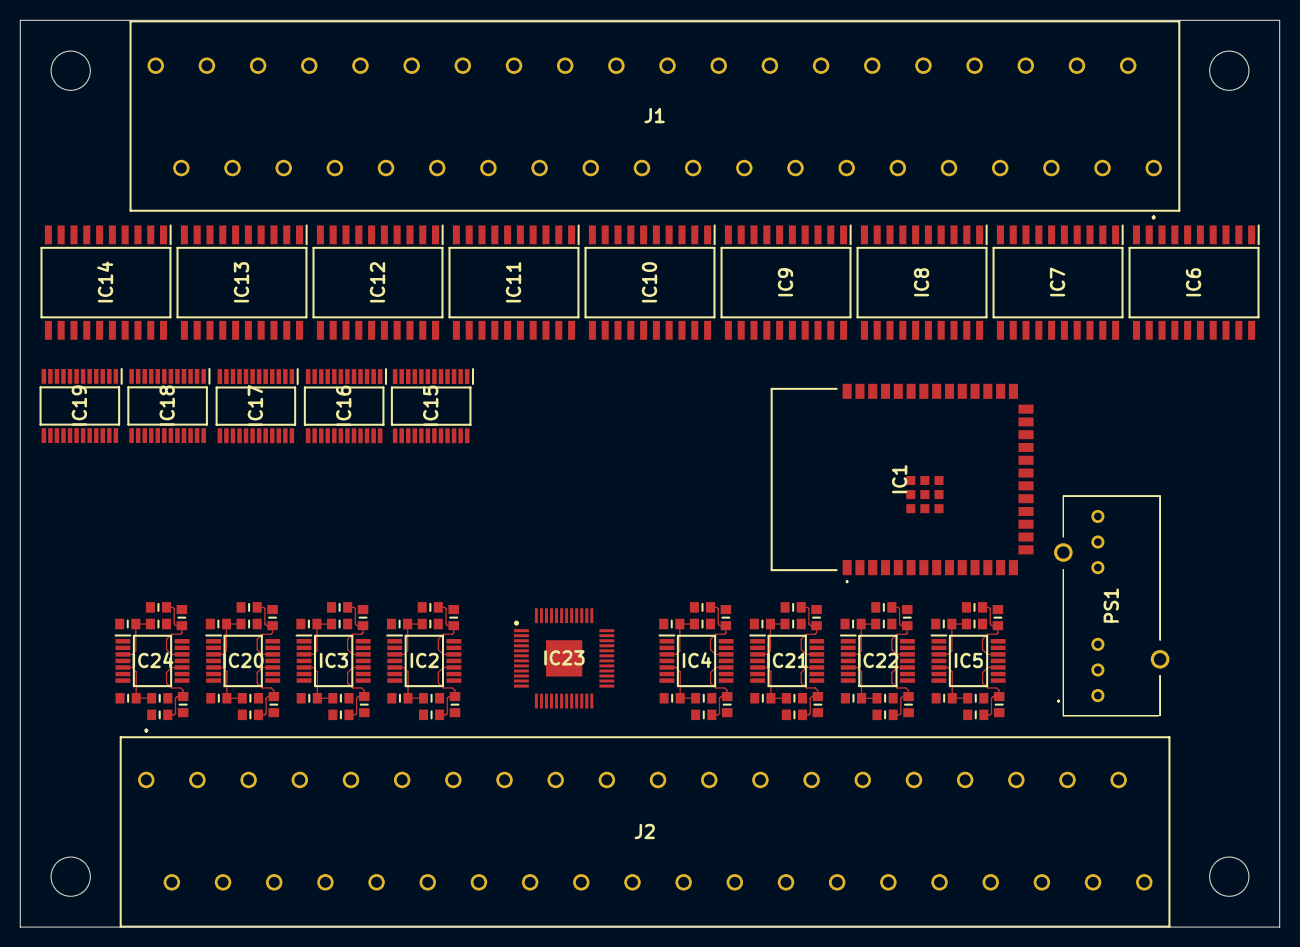
[picture p14: board v2/PLC-CIM.kicad_pcb from above]

Board: 4 copper layers, 125.0 x 90.0 mm, 91 parts (0 on the bottom side), 173 nets.
