jtmaston/CIMPLC-Hardware/v1/PLC-CIM.kicad_pcb

## KiCad design v1/PLC-CIM.kicad_pcb (2023-06-10, an earlier design)

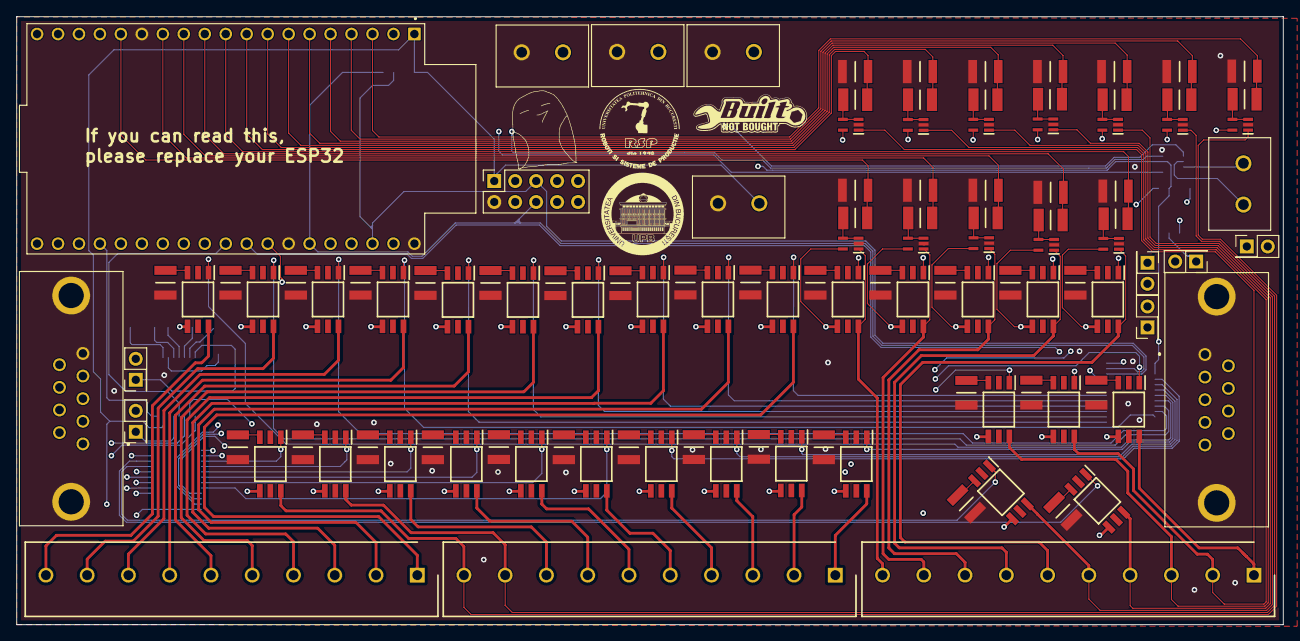
[picture p15: board v1/PLC-CIM.kicad_pcb from above]

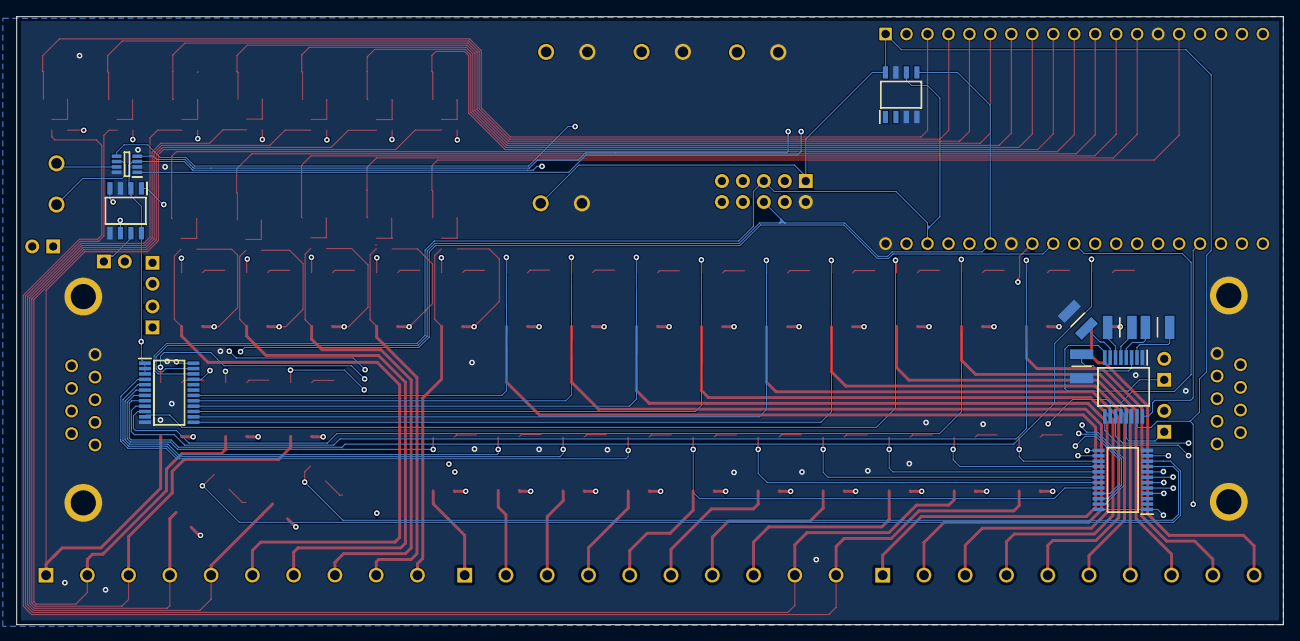
[picture p16: board v1/PLC-CIM.kicad_pcb from below]

Board: 4 copper layers, 153.5 x 73.7 mm, 124 parts (10 on the bottom side), 149 nets.

Parts:
C1, C2, C3, C4: 12103C104KAT2A; CAPC3325X94N
IC1, IC2, IC3, IC4, IC5, IC6, IC13, IC14, IC15, IC16, IC17, IC18, IC25, IC26, IC27, IC28, IC29, IC30, IC32, IC33, IC34, IC35, IC36, IC37, IC38, IC39, IC40, IC41, IC42, IC43: TLP172AM_TPR,E; SOIC127P700X230-6N
IC7, IC8, IC9, IC10, IC11, IC12, IC19, IC20, IC21, IC22, IC23, IC24: TLV9351IDCKR; SOT65P210X110-5N
IC31: MAX3221IDBRE4; SOP65P780X200-16N
IC44, IC46: PCA9555PW,118; SOP65P640X110-24N
IC45: TCAN337DCNR; SOT65P280X145-8N
IC47: SN65HVD75DR; SOIC127P600X175-8N
J1, J2, J3: TB001-500-10BE; SHDR10W100P0X500_1X10_5000X900X1250P
J4, J5, J6, J7, J12: TC0203620000G
J8, J13: 750678-1; 7506781
J9, J10, J14, J15, J16, J17: Conn_02x01; PinHeader_2x01_P2.54mm_Vertical
J11: Conn_02x05_Odd_Even; PinSocket_2x05_P2.54mm_Vertical
R1, R2, R3, R4, R5, R6, R19, R20, R21, R22, R23, R24, R37, R38, R39, R40, R41, R42, R43, R44, R45, R46, R47, R48, R49, R50, R51, R52, R53, R54: CRCW1210267RFKEA; RESC3225X60N
R7, R8, R9, R10, R11, R12, R25, R26, R27, R28, R29, R30: RK73B2ETTD152J; RESC3226X70N
R13, R14, R15, R16, R17, R18, R31, R32, R33, R34, R35, R36: RMCF1210FT10K0; RESC3225X70N
U1: ESP32-DEVKITC; MODULE_ESP32-DEVKITC
U2: AT24CM02-SSHM-B; SOIC127P600X175-8N

Connections:
+3.3V: IC31.15 (VCC), IC44.1 (~INT), IC44.2 (A1), IC44.3 (A2), IC44.24 (VDD), IC45.3 (VCC), IC46.1 (~INT), IC46.2 (A1), IC46.3 (A2), IC46.24 (VDD), IC47.2 (~RE), IC47.8 (VCC), J5.1, J11.1, U1.1 (3V3), U2.8 (VCC)
+24V: IC1.4 (DRAIN_1), IC2.4 (DRAIN_1), IC3.4 (DRAIN_1), IC4.4 (DRAIN_1), IC5.4 (DRAIN_1), IC6.4 (DRAIN_1), IC7.5 (V+), IC8.5 (V+), IC9.5 (V+), IC10.5 (V+), IC11.5 (V+), IC12.5 (V+), IC13.4 (DRAIN_1), IC14.4 (DRAIN_1), IC15.4 (DRAIN_1), IC16.4 (DRAIN_1), IC17.4 (DRAIN_1), IC18.4 (DRAIN_1), IC19.5 (V+), IC20.5 (V+), IC21.5 (V+), IC22.5 (V+), IC23.5 (V+), IC24.5 (V+), IC25.4 (DRAIN_1), IC26.4 (DRAIN_1), IC27.4 (DRAIN_1), IC28.4 (DRAIN_1), IC29.4 (DRAIN_1), IC30.4 (DRAIN_1), IC32.4 (DRAIN_1), IC33.4 (DRAIN_1), IC34.4 (DRAIN_1), IC35.4 (DRAIN_1), IC36.4 (DRAIN_1), IC37.4 (DRAIN_1), IC38.4 (DRAIN_1), IC39.4 (DRAIN_1), IC40.4 (DRAIN_1), IC41.4 (DRAIN_1), IC42.4 (DRAIN_1), IC43.4 (DRAIN_1), J4.1, J6.1, J7.1, J17.2
/O Block 1/O_ACT_1: IC6.1 (ANODE), IC44.4 (I/O0_0)
/O Block 1/O_ACT_2: IC5.1 (ANODE), IC44.5 (I/O0_1)
/O Block 1/O_ACT_3: IC4.1 (ANODE), IC44.6 (I/O0_2)
/O Block 1/O_ACT_4: IC3.1 (ANODE), IC44.7 (I/O0_3)
/O Block 1/O_ACT_5: IC2.1 (ANODE), IC44.8 (I/O0_4)
/O Block 1/O_ACT_6: IC1.1 (ANODE), IC44.9 (I/O0_5)
/O Block 2/O_ACT_1: IC18.1 (ANODE), IC44.10 (I/O0_6)
/O Block 2/O_ACT_2: IC17.1 (ANODE), IC44.11 (I/O0_7)
/O Block 2/O_ACT_3: IC16.1 (ANODE), IC44.13 (I/O1_0)
/O Block 2/O_ACT_4: IC15.1 (ANODE), IC44.14 (I/O1_1)
/O Block 2/O_ACT_5: IC14.1 (ANODE), IC44.15 (I/O1_2)
/O Block 2/O_ACT_6: IC13.1 (ANODE), IC44.16 (I/O1_3)
/O Block 3/O_ACT_1: IC30.1 (ANODE), IC44.17 (I/O1_4)
/O Block 3/O_ACT_2: IC29.1 (ANODE), IC44.18 (I/O1_5)
/O Block 3/O_ACT_3: IC28.1 (ANODE), IC44.19 (I/O1_6)
/O Block 3/O_ACT_4: IC27.1 (ANODE), IC44.20 (I/O1_7)
/O Block 3/O_ACT_5: IC26.1 (ANODE), IC46.4 (I/O0_0)
/O Block 3/O_ACT_6: IC25.1 (ANODE), IC46.5 (I/O0_1)
/O Block 4/O_ACT_1: IC37.1 (ANODE), IC46.6 (I/O0_2)
/O Block 4/O_ACT_2: IC36.1 (ANODE), IC46.7 (I/O0_3)
/O Block 4/O_ACT_3: IC35.1 (ANODE), IC46.8 (I/O0_4)
/O Block 4/O_ACT_4: IC34.1 (ANODE), IC46.9 (I/O0_5)
/O Block 4/O_ACT_5: IC33.1 (ANODE), IC46.10 (I/O0_6)
/O Block 4/O_ACT_6: IC32.1 (ANODE), IC46.11 (I/O0_7)
/O Block 5/O_ACT_1: IC43.1 (ANODE), IC46.13 (I/O1_0)
/O Block 5/O_ACT_2: IC42.1 (ANODE), IC46.14 (I/O1_1)
/O Block 5/O_ACT_3: IC41.1 (ANODE), IC46.15 (I/O1_2)
/O Block 5/O_ACT_4: IC40.1 (ANODE), IC46.16 (I/O1_3)
/O Block 5/O_ACT_5: IC39.1 (ANODE), IC46.17 (I/O1_4)
/O Block 5/O_ACT_6: IC38.1 (ANODE), IC46.18 (I/O1_5)
ADR_1: IC44.21 (A0), U1.31 (IO19)
ADR_2: IC46.21 (A0), U1.30 (IO18)
CAN_FAULT: IC45.5 (FAULT), U1.26 (IO4)
CAN_RX: IC45.1 (TXD), U1.24 (IO2)
CAN_TX: IC45.4 (RXD), U1.25 (IO0)
FORCEOFF: IC31.12 (FORCEON), U1.29 (IO5)
FORCEON: IC31.16 (~FORCEOFF), U1.23 (IO15)
GND: C3.1, C4.2, IC7.2 (V-), IC8.2 (V-), IC9.2 (V-), IC10.2 (V-), IC11.2 (V-), IC12.2 (V-), IC19.2 (V-), IC20.2 (V-), IC21.2 (V-), IC22.2 (V-), IC23.2 (V-), IC24.2 (V-), IC31.1 (~EN), IC31.14 (GND), IC44.12 (VSS), IC45.2 (GND), IC45.8 (S), IC46.12 (VSS), IC47.3 (DE), IC47.5 (GND), J4.2, J5.2, J6.2, J7.2, J8.5, J8.MH1, J8.MH2, J11.2, J13.1, J13.MH1, J13.MH2, R1.2, R2.2, R3.2, R4.2, R5.2, R6.2, R7.2, R8.2, R9.2, R10.2, R11.2, R12.2, R19.2, R20.2, R21.2, R22.2, R23.2, R24.2, R25.2, R26.2, R27.2, R28.2, R29.2, R30.2, R37.2, R38.2, R39.2, R40.2, R41.2, R42.2, R43.2, R44.2, R45.2, R46.2, R47.2, R48.2, R49.2, R50.2, R51.2, R52.2, R53.2, R54.2, U1.14 (GND1), U1.32 (GND2), U1.38 (GND3), U2.3 (A2), U2.4 (GND), U2.7 (WP)
GPIO_1: IC6.6 (DRAIN_2), IC8.1 (IN+), J1.10
GPIO_2: IC5.6 (DRAIN_2), IC7.1 (IN+), J1.9
GPIO_3: IC4.6 (DRAIN_2), IC12.1 (IN+), J1.8
GPIO_4: IC3.6 (DRAIN_2), IC11.1 (IN+), J1.7
GPIO_5: IC2.6 (DRAIN_2), IC10.1 (IN+), J1.6
GPIO_6: IC1.6 (DRAIN_2), IC9.1 (IN+), J1.5
GPIO_7: IC18.6 (DRAIN_2), IC20.1 (IN+), J1.4
GPIO_8: IC17.6 (DRAIN_2), IC19.1 (IN+), J1.3
GPIO_9: IC16.6 (DRAIN_2), IC24.1 (IN+), J1.2
GPIO_10: IC15.6 (DRAIN_2), IC23.1 (IN+), J1.1
GPIO_11: IC14.6 (DRAIN_2), IC22.1 (IN+), J2.10
GPIO_12: IC13.6 (DRAIN_2), IC21.1 (IN+), J2.9
MCU_IN_1: R27.1, R33.2, U1.4 (SENSOR_VN)
MCU_IN_2: R28.1, R34.2, U1.3 (SENSOR_VP)
MCU_IN_3: R29.1, R35.2, U1.9 (IO25)
MCU_IN_4: R30.1, R36.2, U1.8 (IO33)
MCU_IN_5: R25.1, R31.2, U1.7 (IO32)
MCU_IN_6: R26.1, R32.2, U1.6 (IO35)
MCU_IN_7: R9.1, R15.2, U1.5 (IO34)
MCU_IN_8: R10.1, R16.2, U1.10 (IO26)
MCU_IN_9: R11.1, R17.2, U1.11 (IO27)
MCU_IN_10: R12.1, R18.2, U1.12 (IO14)
MCU_IN_11: R7.1, R13.2, U1.13 (IO12)
MCU_IN_12: R8.1, R14.2, U1.15 (IO13)
unnamed: IC1.3 (CATHODE), R1.1
unnamed: IC2.3 (CATHODE), R2.1
unnamed: IC3.3 (CATHODE), R3.1
unnamed: IC4.3 (CATHODE), R4.1
unnamed: IC5.3 (CATHODE), R5.1
unnamed: IC6.3 (CATHODE), R6.1
unnamed: IC7.3 (IN-), IC7.4 (OUT), R13.1
unnamed: IC8.3 (IN-), IC8.4 (OUT), R14.1
unnamed: IC9.3 (IN-), IC9.4 (OUT), R15.1
unnamed: IC10.3 (IN-), IC10.4 (OUT), R16.1
unnamed: IC11.3 (IN-), IC11.4 (OUT), R17.1
unnamed: IC12.3 (IN-), IC12.4 (OUT), R18.1
unnamed: IC13.3 (CATHODE), R19.1
unnamed: IC14.3 (CATHODE), R20.1
unnamed: IC15.3 (CATHODE), R21.1
unnamed: IC16.3 (CATHODE), R22.1
unnamed: IC17.3 (CATHODE), R23.1
unnamed: IC18.3 (CATHODE), R24.1
unnamed: IC19.3 (IN-), IC19.4 (OUT), R31.1
unnamed: IC20.3 (IN-), IC20.4 (OUT), R32.1
unnamed: IC21.3 (IN-), IC21.4 (OUT), R33.1
unnamed: IC22.3 (IN-), IC22.4 (OUT), R34.1
unnamed: IC23.3 (IN-), IC23.4 (OUT), R35.1
unnamed: IC24.3 (IN-), IC24.4 (OUT), R36.1
unnamed: IC25.3 (CATHODE), R37.1
unnamed: IC26.3 (CATHODE), R38.1
unnamed: IC27.3 (CATHODE), R39.1
unnamed: IC28.3 (CATHODE), R40.1
unnamed: IC29.3 (CATHODE), R41.1
unnamed: IC30.3 (CATHODE), R42.1
unnamed: C1.2, IC31.2 (C1+)
unnamed: C1.1, IC31.4 (C1-)
unnamed: C2.2, IC31.5 (C2+)
unnamed: C2.1, IC31.6 (C2-)
unnamed: IC31.13 (DOUT), J9.1
unnamed: IC31.8 (RIN), J10.1
unnamed: C3.2, IC31.3 (V+)
unnamed: C4.1, IC31.7 (V-)
unnamed: IC32.3 (CATHODE), R43.1
unnamed: IC33.3 (CATHODE), R44.1
unnamed: IC34.3 (CATHODE), R45.1
unnamed: IC35.3 (CATHODE), R46.1
unnamed: IC36.3 (CATHODE), R47.1
unnamed: IC37.3 (CATHODE), R48.1
unnamed: IC38.3 (CATHODE), R49.1
unnamed: IC39.3 (CATHODE), R50.1
unnamed: IC40.3 (CATHODE), R51.1
unnamed: IC41.3 (CATHODE), R52.1
unnamed: IC42.3 (CATHODE), R53.1
unnamed: IC43.3 (CATHODE), R54.1
unnamed: IC45.7 (CANH), J12.2
unnamed: IC45.6 (CANL), J12.1
unnamed: IC47.6 (A), J15.1
unnamed: IC47.7 (B), J14.1
unnamed: J8.2, J9.2
unnamed: J8.3, J10.2
unnamed: J13.3, J14.2
unnamed: J13.8, J15.2
unnamed: J13.6, J16.1
unnamed: J13.7, J17.1
OUT_13: IC30.6 (DRAIN_2), J2.8
OUT_14: IC29.6 (DRAIN_2), J2.7
OUT_15: IC28.6 (DRAIN_2), J2.6
OUT_16: IC27.6 (DRAIN_2), J2.5
OUT_17: IC26.6 (DRAIN_2), J2.4
OUT_18: IC25.6 (DRAIN_2), J2.3
OUT_19: IC37.6 (DRAIN_2), J2.2
OUT_20: IC36.6 (DRAIN_2), J2.1
OUT_21: IC35.6 (DRAIN_2), J3.10
OUT_22: IC34.6 (DRAIN_2), J3.9
OUT_23: IC33.6 (DRAIN_2), J3.8
OUT_24: IC32.6 (DRAIN_2), J3.7
OUT_25: IC43.6 (DRAIN_2), J3.6
OUT_26: IC42.6 (DRAIN_2), J3.5
OUT_27: IC41.6 (DRAIN_2), J3.4
OUT_28: IC40.6 (DRAIN_2), J3.3
OUT_29: IC39.6 (DRAIN_2), J3.2
OUT_30: IC38.6 (DRAIN_2), J3.1
RS232_STATUS: IC31.10 (~INVALID), U1.37 (IO23)
RX0: IC31.9 (ROUT), U1.34 (RXD0)
RX1: IC47.1 (R), U1.27 (IO16)
SCL: IC44.22 (SCL), IC46.22 (SCL), J11.5, U1.36 (IO22), U2.6 (SCL)
SDA: IC44.23 (SDA), IC46.23 (SDA), J11.6, U1.33 (IO21), U2.5 (SDA)
TX0: IC31.11 (DIN), U1.35 (TXD0)
TX1: IC47.4 (D), U1.28 (IO17)
