jtmaston/CIMPLC-Hardware/(commit log)

2023-06-10 Removed firmware files
    [CanXCIEVER.kicad_sch, EEPROM.kicad_sch, IO_Block.kicad_sch, IO_Block_1.kicad_sch, I_Block.kicad_sch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]
2023-06-11 Cleaned up the repository
    [CanXCIEVER.kicad_sch, EEPROM.kicad_sch, IO_Block.kicad_sch, IO_Block_1.kicad_sch, I_Block.kicad_sch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]
2023-06-25 Automate library addition * Added script to automagically extract samacsys libraries and put them in corresponding folders. * Note: Requires zsh
    [CanXCIEVER.kicad_sch, EEPROM.kicad_sch, IO_Block.kicad_sch, IO_Block_1.kicad_sch, I_Block.kicad_sch, PLC-CIM.kicad_pcb, PLC-CIM.kicad_sch, PM.kicad_sch]
2023-12-05 Testing documentation
    [IO_Block_1.kicad_sch, IO_Term_Block.kicad_sch, PLC-CIM.kicad_sch, PLC-CIM.step]
2023-12-05 Testing writerside documentation
    [writerside.cfg]
2023-12-05 Moved dirs around
    [writerside.cfg]
2023-12-05 Re-add docfiles
    [writerside.cfg]
2023-12-05 Build documentation
    [writerside.cfg]
2023-12-05 Separate v1 and v2 development
    [CanXCIEVER.kicad_sch, EEPROM.kicad_sch, IO_Block.kicad_sch, IO_Block_1.kicad_sch, IO_Term_Block.kicad_sch, I_Block.kicad_sch, PLC-CIM.kicad_pcb, PLC-CIM.kicad_sch]
2023-12-08 Update views, to make drawing sheets smaller where necessary
    [CanXCIEVER.kicad_sch, EEPROM.kicad_sch, IO_Block_1.kicad_sch, I_Block.kicad_sch, RS232.kicad_sch, RS485.kicad_sch, remoteIOBlock.kicad_sch]
2024-04-08 Start proper work on V2.1
    - Replaced all blocks
    - Added input blocks
    - Added output blocks
    - Added initial CAD placement
    - Added initial routing
    - General system stability improvements to enhance the user's experience
    [ASS.kicad_sch, CanXCIEVER.kicad_sch, EEPROM.kicad_sch, IO_Block.kicad_sch, IO_Block_1.kicad_sch, IO_Term_Block.kicad_sch, I_Block.kicad_sch, PLC-CIM.kicad_pcb]
